Danjovic/PassKey/README.md

# PassKey
Keychain USB multiple password manager/generator/injector

This project provides an usb device to stor passwords that can be sent to your PC like keystrokes. 
It was inspired by USB Key Generator by Code & Life, and therefore is also based on AVR and V-USB.
