Danjovic/PassKey/circuit/BOM.txt

Key Pass - Bill of Materials

Part   Part Number          Description                                                   Link
IC1    ATMega8-16AU         AVR Microcontroller, 8K Flash TQFP32-08                       http://br.mouser.com/ProductDetail/Atmel/ATmega8-16AU/?qs=sGAEpiMZZMvqv2n3s2xjsVIKSdqlAUq6z54aCTlntIM%3d
DS1    SC56-11GWA           Single Digit Numeric Display, 7 Segment, 14.2mm (0.56 INCH)   http://br.mouser.com/ProductDetail/Kingbright/SC56-11GWA/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
D1,D2  ZMM5226B             Zener diode,  0.5W 3.3V 5% , SOD80C                           http://br.mouser.com/ProductDetail/Rectron/ZMM5226B/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 
C1     12065C104KAT2A       Multilayer Ceramic Capacitor, 0.1uF/50volts, 1206 package     http://br.mouser.com/ProductDetail/AVX/12065C104KAT2A/?qs=sGAEpiMZZMsh%252b1woXyUXj%2fQOiMy2nwZAegeDXPYKDmA%3d                                                                                                                                                                                                                                                    
C2,C3  VJ0805A220JXGAT5Z    Multilayer Ceramic Capacitors, 22pF 1KV, 0805 package         http://br.mouser.com/ProductDetail/Vishay-Vitramon/VJ0805A220JXGAT5Z/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
R1     CRCW08052K20FKEA     Thick Film Resistors, 2k2 Ohms, 1/8watt, 1%, 0805 package     http://br.mouser.com/ProductDetail/Vishay-Dale/CRCW08052K20FKEA/?qs=sGAEpiMZZMuMxemD0lCBEQzL59S3xDaM                                                                                                                                  
R1     CRCW080568R0FKEA     Thick Film Resistors, 68 Ohms, 1/8watt, 1%, 0805 package      http://br.mouser.com/ProductDetail/Vishay-Dale/CRCW080568R0FKEA/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
R4     CRCW080510K0FKEA     Thick Film Resistors, 10k Ohms, 1/8watt, 1%, 0805 package     http://br.mouser.com/ProductDetail/Vishay-Dale/CRCW080510K0FKEA/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                                                                                                                                          
R5     CRCW0805470RFKEA     Thick Film Resistors, 470 Ohms, 1/8watt, 1%, 0805 package     http://br.mouser.com/ProductDetail/Vishay-Dale/CRCW0805470RFKEA/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 
XT1    HCM49-16.000MABJ-UT  Crystal 16MHz  HC49S SMD                                      http://br.mouser.com/ProductDetail/Citizen/HCM49-16000MABJ-UT/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
S1,S2  B3F-3122             Tactile Switch R/A 6X6 3.85mm BTN                             http://br.mouser.com/ProductDetail/Omron/B3F-3122/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
K1     48037-0001           USB Connector TYPE A RA SHLDED PLG THRU-HOLE AU               http://br.mouser.com/ProductDetail/Molex/48037-0001/?qs=%2fha2pyFaduinMl8uohyjMe6YZYgp2j6CnudoqvbRJ1c%3d
