Danjovic/PassKey/circuit/Key_Pass.brd

## EAGLE design circuit/Key_Pass.brd (2015-11-06)

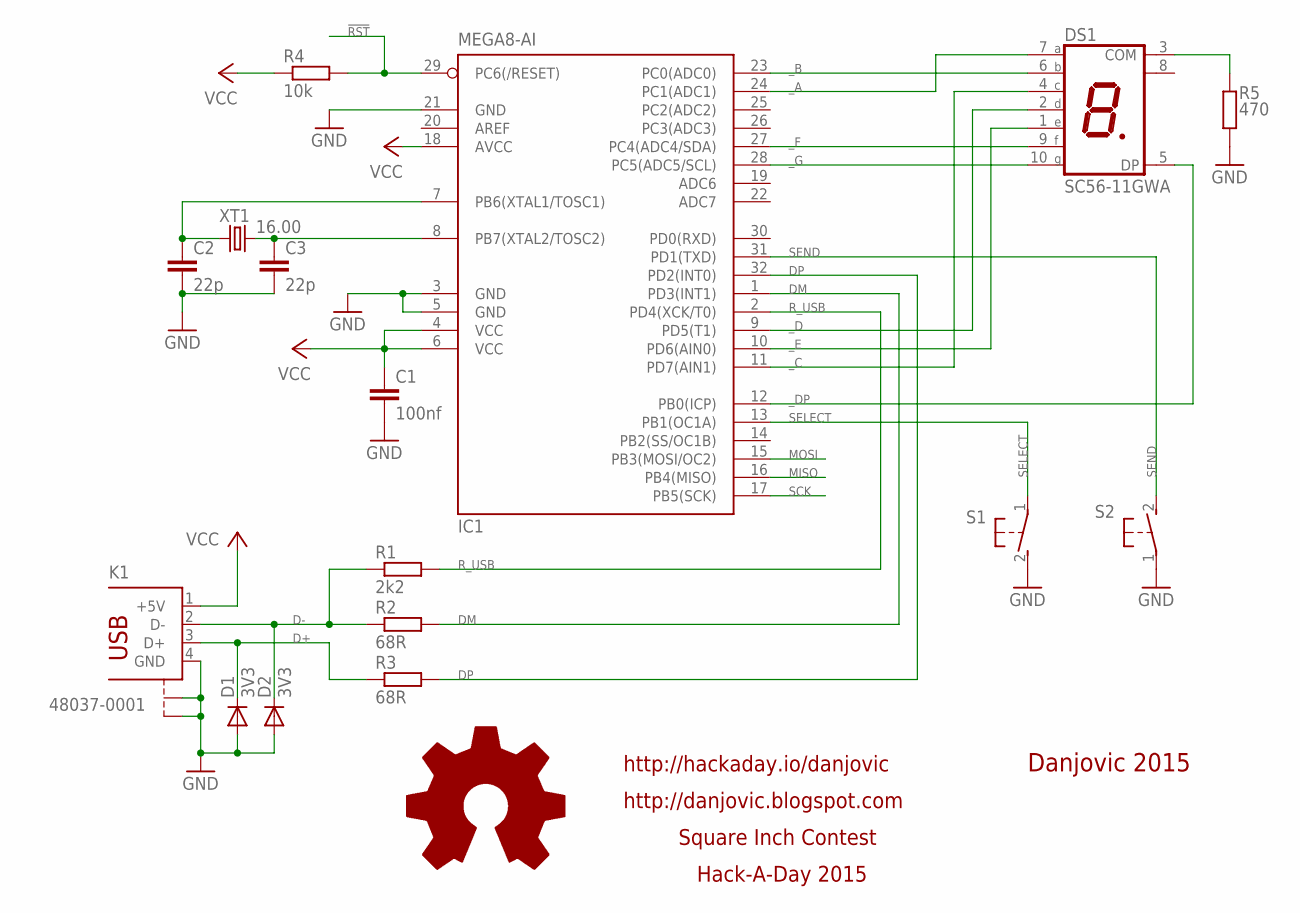
[picture p1: schematic Key_Pass.sch]

Parts:
C1: 100nf; C1206
C2, C3: 22p; C0805
D1, D2: 3V3; SOD80C
DS1: SC56-11GWA; SA52-11
IC1: MEGA8-AI; TQFP32-08
K1: 48037-0001
R1: 2k2; R0805
R2, R3: 68R; R0805
R4: 10k; R0805
R5: 470; R0805
S1, S2: 31-XX; B3F-31XX
XT1: 16.00; HC49UP

Connections:
!RST: IC1.29 (PC6(/RESET)), R4.2
D+: D1.C, K1.3 (D+), R3.1
D-: D2.C, K1.2 (D-), R1.1, R2.1
DM: IC1.1 (PD3(INT1)), R2.2
DP: IC1.32 (PD2(INT0)), R3.2
GND: C1.2, C2.1, C3.1, D1.A, D2.A, IC1.3 (GND), IC1.5 (GND), IC1.21 (GND), K1.4 (GND), K1.P$1 (S1), K1.P$2 (S2), R5.1, S1.2 (S), S2.1
MISO: IC1.16 (PB4(MISO))
MOSI: IC1.15 (PB3(MOSI/OC2))
unnamed: DS1.3 (COM), R5.2
unnamed: C2.2, IC1.7 (PB6(XTAL1/TOSC1)), XT1.1
R_USB: IC1.2 (PD4(XCK/T0)), R1.2
SCK: IC1.17 (PB5(SCK))
SELECT: IC1.13 (PB1(OC1A)), S1.1
SEND: IC1.31 (PD1(TXD)), S2.2 (S)
VCC: C1.1, IC1.4 (VCC), IC1.6 (VCC), IC1.18 (AVCC), K1.1 (+5V), R4.1
X1: C3.2, IC1.8 (PB7(XTAL2/TOSC2)), XT1.2
_A: DS1.7 (A), IC1.24 (PC1(ADC1))
_B: DS1.6 (B), IC1.23 (PC0(ADC0))
_C: DS1.4 (C), IC1.11 (PD7(AIN1))
_D: DS1.2 (D), IC1.9 (PD5(T1))
_DP: DS1.5 (DP), IC1.12 (PB0(ICP))
_E: DS1.1 (E), IC1.10 (PD6(AIN0))
_F: DS1.9 (F), IC1.27 (PC4(ADC4/SDA))
_G: DS1.10 (G), IC1.28 (PC5(ADC5/SCL))

Notes on the sheet:
Danjovic 2015
http://hackaday.io/danjovic
http://danjovic.blogspot.com
Square Inch Contest
Hack-A-Day 2015

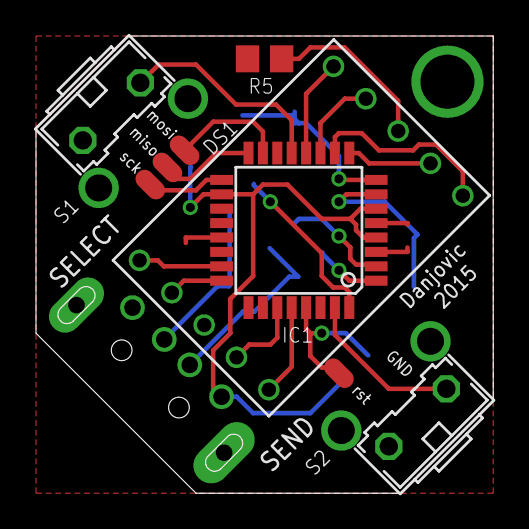
[picture p2: board Key_Pass.brd from above]

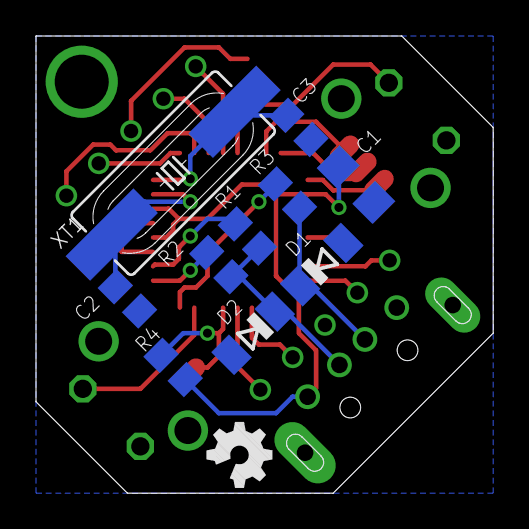
[picture p3: board Key_Pass.brd from below]

Board: 2 copper layers, 25.4 x 25.4 mm, 16 parts (10 on the bottom side), 21 nets.
