Danjovic/PassKey/(commit log)

2015-11-06 Test Release
    First working version. Limitations:
    1) Bootloader activated by RESET
    2) Can not disable use of NUM LOCK / SCROLL LOCK
    [Key_Pass.brd, Key_Pass.sch]
2015-11-12 Enabling/Disabling NUM_LOCK and SCROLL_LOCK; saving of last sent slot
    The functions to enable/disable alternative control by NUM LOCK (change
    slot) and SCROLL LOCK (send password) were added. Both configurations
    are saved in EEPROM, as well as the last slot number selected when a
    password was sent.
2015-11-13 Enter bootloader by press SELECT and SEND together
    Bootloader modified to enter in bootloader state when SELECT and SEND
    are both pressed when the device is inserted on USB port. After entering
    bootloader, the alternative activation by Num_Lock and Scroll_Lock are
    set by default as well as the current Slot is changed to '0' and the
    flag that indicates an Upload has occurred is set. This configuration is
    stored on the last address of EEPROM ( E2END )
    [Key_Pass.brd, Key_Pass.sch]
2015-11-28 Added License files
    [Key_Pass.brd, Key_Pass.sch]
